mikeneiderhauser/net2rf-led/docs/API.md

# HTTP API

All endpoints are JSON. POST bodies are JSON objects. Errors return `{"ok": false, "error": "..."}` with a 4xx/5xx status.
Successful writes return `{"ok": true, "reboot": <bool>}`; when `reboot` is true the controller restarts about a second later.

## Request rules

Every state-changing `POST` must:

- send a JSON body with `Content-Type: application/json` (otherwise `415`);
- address the controller by IP or by its own name (`net2rf-xxxx`, `net2rf-xxxx.local`, `net2rf.local`);
  any other host name gets `403`, including the same name under another domain (`net2rf-xxxx.lan`), since a
  DNS-rebinding page can pick its own domain. Use the IP when your router publishes its own DNS names;
- if sent from a browser, come from the controller's own page (the `Origin` header must match).

These stop other websites from making your browser change settings or flash firmware behind your back. Scripts,
curl and Home Assistant are unaffected as long as they set the JSON content type. `/update` (multipart) is exempt from
the content-type rule but not from the other two.

## Authentication

Off by default. Once an admin password is set (`POST /api/auth`), every endpoint marked 🔒 needs HTTP Basic auth
with user `admin`:

```bash
curl -u admin:yourpassword http://net2rf-3f2a.local/api/config
```

Missing or wrong credentials return `401` with a `WWW-Authenticate: Basic` challenge (browsers show a login prompt).
After 5 wrong passwords, all attempts are refused with `429` for 30 s. The password is stored as a salted SHA-256
hash. Basic auth is not encrypted on the wire, so treat it as protection on a trusted LAN, not across the internet.
Forgotten password: hold the front-panel button 5 s (network reset), which clears it along with the network settings.

| Method | Path | Purpose |
|---|---|---|
| GET | `/` | Web UI |
| GET | `/api/status` | Device, network and engine status (polled by the UI every second). Always open. `device.free_heap` / `min_free_heap` / `heap_bytes` are RAM in bytes (free now, lowest since boot, total); `device.firmware_bytes` and `device.firmware_slot_bytes` give the firmware's size and the flash slot it must fit in (free flash = the difference). |
| GET | `/json/info`, `/json/cfg` | The part of WLED's JSON API that xLights' WLED upload driver reads: device info, and port 1's pixel count (= zones) and input. `brand` is `Net2RF`, so xLights' WLED discovery ignores the controller. Always open. |
| POST 🔒 | `/json/cfg` | What xLights posts on *Upload*: `hw.led.ins[0].len` sets the number of zones (pixel mode; 1-16), `if.live.port` 4048 enables DDP and 5568 enables E1.31 with `if.live.dmx.uni`. Start channel becomes 1. A zone added this way gets its own group unless it was configured before. WLED's per-port colour order is ignored (it describes LED wiring; the controller's colour order must match the model's String Type). Art-Net, more than one port or more than 16 pixels return 400. |
| GET | `/api/flash` | Flash chip size and the partition table: `label`, `offset`, `bytes`, `kind`, and `used_bytes` for the running firmware slot and the settings store. Shown under *System → Advanced: flash storage*. Always open. |
| GET 🔒 | `/api/crash` | The last crash, from the dump the controller keeps in flash: `present`, `task`, `reason`, `pc`, `address`, `backtrace` (addresses to look up in that build's `firmware.elf`), `elf_sha256`. Stays until the next crash. |
| GET | `/api/heap` | Memory diagnostics: `free`, `largest_block` (what one big allocation can get), `min_free`, block counts, and per task `stack_unused`. |
| GET 🔒 | `/api/store` | Board records kept on the data partition: `mounted`, `total_bytes`, `used_bytes`, `boot_no`, `writes` (file writes over the partition's life), `record_seen`, `boot_log_paused`, and `files` (`name`, `bytes`). See [Board records](#board-records). |
| POST 🔒 | `/api/store` | `{"record_seen": true}`: also write the transmitters receiver mode hears to flash (off by default). |
| GET 🔒 | `/api/store/boots` | The boot log: `boots` (count since the log began), `abnormal_streak`, `entries` (`n`, `reason`, `fw`, `prev_uptime_s`, and `pc` after a crash), oldest first, the last 32. |
| GET 🔒 | `/api/store/seen` | Transmitters receiver mode has decoded: `entries` (`protocol`, `address`, `group` for protocol 1, `count`, `first_boot`, `last_boot`, `best_rssi_dbm`). |
| GET 🔒 | `/api/store/captures` | Saved captures without their pulses; with `?slot=N` one capture in full (same shape as `/api/rx/capture`). |
| POST 🔒 | `/api/store/captures` | `{"id": N, "note": "..."}` keeps receiver capture N (replies `slot`; 507 when all 6 slots are used). `{"delete": slot}` frees one. |
| POST 🔒 | `/api/store/clear` | `{"what": "boots" \| "seen" \| "captures" \| "all"}` |
| GET 🔒 | `/api/store/file?name=boots.json` | One stored file, as a download. |
| POST 🔒 | `/api/store/file` | `{"delete": "cap0.json"}` deletes one stored file. `boots.json` restarts the restart count, `seen.json` empties the heard list, `store.json` puts recording back to off. |
| GET 🔒 | `/api/store/bundle` | One diagnostics file for a fault report: status, last crash, boot log, heard transmitters, saved captures (no pulses) and settings. Never the Wi-Fi or admin password. |
| GET 🔒 | `/api/config` | Current settings (`app` + `network`, without passwords) |
| POST 🔒 | `/api/config` | Update app settings. Any subset of the fields below. Changing `radio.type` reboots. |
| POST 🔒 | `/api/network` | Update network settings, then reboot |
| GET | `/api/stats` | Compact counters for monitoring (see below). Always open. |
| GET | `/api/discover` | This controller plus every other controller it knows of, with live state (see *Controller discovery*). Always open. |
| POST | `/api/discover` | Run an mDNS search now (otherwise every 60 s; heartbeats arrive continuously) |
| POST 🔒 | `/api/auth` | `{"password": "..."}`: set or change the admin password (8-64 characters); `""` removes it |
| POST 🔒 | `/api/output` | `{"enabled": true\|false}`: global RF switch (persisted). Disabled = DDP is consumed and counted, nothing is transmitted. |
| POST 🔒 | `/api/radio` | `{"power": true\|false}`: radio chip power (persisted). `false` puts the chip to sleep: `radio.state` reads `off`, show data is still counted, and sends return 409 (`radio is shut down`). `true` re-initialises it and re-sends the current colours. |
| POST 🔒 | `/api/test` | `{"mode": "off"\|"solid"\|"cycle"\|"fade"\|"flicker", "rgb": "FF0000"}`: override DDP input. **fade** holds each colour of a palette, then fades to the next, round and round: `"palette": ["FF5000", "7000FF", ...]` (1-8 colours), `"fade_s"`, `"hold_s"` (0-600); anything left out keeps the Halloween default (orange, purple, green, red, candle yellow; 3 s / 4 s). It sends a step about every 0.3 s while fading and nothing while holding. **flicker** is a candle in the `rgb` colour: a random level (55-100 %, redder when dimmer) about 3 times a second. `"boot": true` also starts this mode, with its colours, at every power-up; `false` (or `"off"` with `"boot": false`) stops that. The status shows `engine.test` = `{mode, rgb, boot, fade: {palette, fade_s, hold_s}}`. |
| GET | `/api/amp` | Amplifier power switch (see *Amplifier power switch* below): `{fitted, active_low, on, pin, shares_status_led}`. Also in `/api/status` as `device.amp`. Always open. |
| POST 🔒 | `/api/amp` | Any of `{"fitted": true, "active_low": true, "on": false}`, saved and kept across restarts. Returns `{"ok": true, "amp": {...}}`. 400 for a value that isn't true/false. |
| POST 🔒 | `/api/send` | `{"zone": 0, "action": "color"\|"off"\|"fxa"\|"fxb"\|"fxc", "rgb": "FF0000"}` (protocol 0: `fxa` = fade in to the last colour, `fxb` = fade out, `fxc` = a third effect packet with no known result); `"zone": "all"` (or -1) = every bracelet: one broadcast packet on protocol 1, one per enabled zone on protocol 0. `"all"` + `"off"` behaves like `/api/all-off`. 400 for a zone that isn't saved; 409 when output is disabled. |
| POST 🔒 | `/api/all-off` | Leave test mode and switch every bracelet off. Bracelets then stay off until the input changes a colour. 409 when output is disabled. |
| GET | `/api/tools` | Live data for the Tools page: `tx` = the last 24 transmissions, newest first (`age_ms`, `p` protocol, `pkt` hex, `n` repeats, `manual`, `ok`), `tx_total`, and `input` (`start`, `width`, `channels`: the raw values the zones read). Always open. |
| GET 🔒 | `/api/rssi` | Listen on the bracelet frequency for about 20 ms, between transmissions: `peak_dbm`, `avg_dbm`, `freq_hz`. 409 if the radio can't listen (off, not ready). |
| POST 🔒 | `/api/identify` | `{"seconds": 15}` (0-120; 0 stops): flicker the status LED and flash the OLED |
| POST 🔒 | `/api/display` | Any of `{"type": "ssd1306"\|"sh1106", "sleep_min": 10, "wake": true}`: OLED driver, minutes without a USER press before it sleeps (0-240, 0 = never), and switch a sleeping display back on. `device.display_info` in `/api/status` has `asleep`, `sleep_min` and `button`. |
| POST 🔒 | `/api/raw` | `{"protocol": 1, "hex": "55000FFFFF55FF", "repeats": 3, "fix": true}`. 409 when output is disabled. |
| POST 🔒 | `/api/stats/reset` | Zero the packet counters |
| POST / GET 🔒 | `/api/wifi/scan` | Start a scan / read results |
| GET 🔒 | `/api/export` | Download settings. `?part=settings` gives the `app` part, `?part=network` the `network` part, each as its own file; without `part` the file holds both. Passwords are never included. |
| POST 🔒 | `/api/import` | Body = an export file. Replaces the parts it holds (`app`, `network` or both) and leaves the other alone. Reboots. |
| POST 🔒 | `/api/reset` | `{"what": "settings"\|"network"\|"all"}`: put that part back to defaults (`all` = both). Reboots. |
| POST 🔒 | `/api/reboot` | Reboot |
| POST 🔒 | `/api/factory-reset` | Same as `/api/reset` with `all` |
| POST 🔒 | `/api/update/latest` | `{"tag": "v1.2.3"}`: the web UI reports the latest release it found on GitHub, so the dashboard and the OLED can show that a newer version exists. Kept in memory only. The controller never contacts GitHub for updates itself. |
| POST 🔒 | `/update` | `multipart/form-data` firmware upload (`firmware.bin`). Origin and credentials are checked before anything is written to flash. Reboots when done; see *Update rollback*. |

## Amplifier power switch

An optional output that powers an external RF amplifier up and down, e.g. through its 12 V → 5 V buck's EN pin
([assembly guide](ASSEMBLY.md#amplifier-power-switch)). It uses `pin` (IO2 on the WT32-ETH01, D1 on the XIAO).

- `fitted`: a switch is wired to the pin. Until then the firmware leaves the pin alone (default `false`). On the
  WT32-ETH01, IO2 is also the status LED's pin (`shares_status_led`), and the LED is not driven while a switch is
  fitted.
- `active_low`: the pin is low while the amp is on (default `true`): an N-FET that pulls the buck's EN low when the
  pin goes high. `false` for a switch that is on while the pin is high (e.g. a high-side P-FET driven through an
  N-FET).
- `on`: the amp is powered. Kept across restarts. Reads `false` while no switch is fitted.

Before the firmware starts, IO2 is low (it must be, for serial flashing), so with an active-low switch the amp is
powered during boot.

## Settings (`/api/config` → `app`)

```json
{
  "name": "Front Yard",
  "output_enabled": true,
  "role": "controller",
  "devices": {"protocols": [0, 1], "per_zone": true, "protocol": 0, "mode": "pixel", "color_order": "RGB"},
  "input":     {"ddp_enabled": true, "ddp_port": 4048, "e131_enabled": false, "e131_universe": 1,
                "e131_multicast": true, "start_channel": 1, "timeout_s": 300},
  "radio":     {"type": "cc1101", "tx_power": 10, "freq_p0": 433889000, "freq_p1": 433920000,
                "repeats": 3, "off_threshold": 16, "refresh_ms": 0, "tx_jitter_ms": 0,
                "lbt_enabled": false, "lbt_threshold_dbm": -75, "power": true},
  "sync":      {"enabled": false, "master": false, "copies": 1},
  "zones": [
    {"enabled": true, "name": "Bracelets", "protocols": [0], "addr_p0": "0002000F", "addr_p1": "01FF", "start": 1},
    {"enabled": true, "name": "Pucks", "protocols": [1], "addr_p0": "0004000F", "addr_p1": "05FF", "start": 4},
    {"enabled": true, "name": "Everyone", "protocols": [0, 1], "addr_p0": "00FFFF0F", "addr_p1": "00FF", "start": 7}
  ]
}
```

- Protocols: 0 = Shenzen New Dody (433.889 MHz, 10-colour palette), 1 = LedGiftSupplier.com (433.920 MHz, RGB,
  group codes). **Each zone drives its own** (`zones[].protocols`: `[0]`, `[1]` or `[0, 1]`), and only those go
  on air: a zone on `[0]` never costs protocol 1 airtime. A zone on both sends every change twice, protocol 0 then
  protocol 1 (an FX channel effect becomes "off" for fade out, and the plain colour otherwise, on protocol 1,
  which has no effects). Broadcasts (All off, input-timeout blanking, test colours) go only to protocols some
  enabled zone uses.
- `devices.protocols` (write): sets every zone at once. Read: what every zone uses, or, with `per_zone: true`,
  what the zones use between them. `devices.protocol` is the default protocol (new zones when they differ, the
  channel meter); an older client that changes it switches every zone to that protocol. Zones always keep an
  address in both protocols, so nothing has to be re-entered when a zone changes protocol.
- `devices.base_layer` (protocol 0): the zone addressed to every group (mask `FFFF`) is a base layer. A zone
  whose colour is not black is cut out of that zone's address ("everyone except"), so base changes don't
  reach it; a black zone follows the base and gets no packet of its own while the base's broadcast covers
  it. Zones that change to the same command at the same moment are sent as one packet with their masks
  combined. Default `true` for new settings, `false` for settings saved by older firmware. In `/api/status` the
  base zone's `packet` shows the address actually used (e.g. `00FBFF0F` with group 2 cut out).
- `devices.mode`: `pixel` (3 channels per zone: R G B in `color_order`), `dmx` (4: R, G, B, FX) or `vendor`
  (5: boot code, group, R, G, B, the LedGiftSupplier DMX transmitter's layout). Vendor mode drives protocol 1 only,
  so every enabled zone must use protocol 1 (a zone also on protocol 0 sends only protocol 1). A zone only transmits
  while its first channel is 85, and the group comes from its second channel.
- `zones[].addr_p0`: 4 bytes (packet bytes 0-3; `00FFFF0F` = all groups, `0002000F` = group 1, `0004000F` =
  group 2, ...). `zones[].addr_p1`: group code byte + byte 6 (`00FF` = group 0, all groups; `01FF` = group 1).
  Factory default: protocol 0 with five zones, *All Zones* and *Zone 1* to *4* (groups 1-4). Zone *k* defaults
  to group *k* in both protocols, and zone 0 to all groups. `zones[].start` is read-only: zone *k* starts at
  `start_channel + k × (3, 4 or 5)`. Older clients and exports may send one `addr` per zone: it is read in the
  default protocol, and the zone then drives that protocol alone. Settings saved by firmware before per-zone
  protocols load with every zone on the controller's old protocol and its address kept.
- `/api/status` → `engine.zones[].packets`: the last packet sent on each of the zone's protocols (`p`, `pkt`);
  `packet` is the first of them.
- Transmit order: zones are sent when their colour changes, taking turns. When zones that reach the same
  bracelets change together, the broader address goes first (all groups before a single group), so the more
  specific colour lands last.
- `radio.type`: `cc1101` or `sx1278`. A new or reset controller starts on `sx1278` (WT32-ETH01) or `cc1101` (XIAO ESP32-S3). `tx_power` is clamped to the module's range. `refresh_ms` defaults to 0
  (send on change only): the bracelets latch, and extra airtime only adds interference.
- `radio.power`: `false` = radio chip shut down (same as `POST /api/radio`).
- `role`: `controller` (default) or `receiver`. A receiver never transmits: it listens between the two protocol
  frequencies and decodes both protocols. `/api/status` → `engine.receiver` has `enabled`, `active` (listening),
  `supported` (CC1101 fitted), `freq`, `frames` (decoded), `bad` (right shape, wrong checksum), `updates`
  (distinct commands), `rssi_dbm` / `rssi_peak_dbm` (channel level over the last 0.5 s), `last_age_ms`, `zones`
  (per group: `p`, `group` (`"all"` = every group), `rgb`, `label` (protocol 0 colour or effect), `pkt`, `updates`,
  `age_ms`, `rssi_dbm`) and `noise_pauses` (times a flood of noise edges paused listening for 50 ms, to keep the controller responsive), `log`
  (latest transmissions, newest first: `p`, `pkt`, `n` copies heard, `rssi_dbm`,
  and for protocol 1 `checksum`: `vendor` or `legacy`). `POST /api/stats/reset` clears it. Transmit requests return
  409 in receiver mode.
- `rx_profile`: receiver tuning, `normal` (default), `near` (gain capped, for a transmitter within a few metres) or
  `wide` (wider bandwidth). `engine.receiver.profile` and `.bandwidth` (Hz) report it.
- Raw captures: `engine.receiver.captures` lists the stored bursts, newest first (`id`, `age_ms`, `pulses`, `us`
  total length, `decoded`, `truncated` at 1024 pulses, `rssi_dbm` peak). `captures_quiet` counts bursts dropped
  for being no louder than the noise floor. `GET /api/rx/capture?id=N` returns one: `pulses` is a list of
  durations in µs, positive = carrier on, negative = off. Add `&format=ook` for rtl_433's pulse-data text.
- `display.sleep_min`: minutes without a USER button press before the OLED switches off (default 10, 0 = never).
- `update.repo`: GitHub repository (`owner/name`) whose releases the web UI offers as firmware updates.
  Default `mikeneiderhauser/net2rf-led`; `""` restores the default.
- `radio.lbt_enabled` (listen before transmit, off by default): before each update the radio listens for 2.5 ms
  and only transmits if the strongest signal stayed below `lbt_threshold_dbm` (-120..-30, default -75).
  Otherwise it backs off a random 3-15 ms and listens again, for at most 250 ms, then sends anyway. Set the
  threshold about 10 dB above the quiet reading shown on *Devices & Radio* (`radio.lbt.last_rssi_dbm` in
  `/api/status`). See [RF.md](RF.md#multiple-controllers).
- `sync`: coverage group ([RF.md](RF.md#coverage-group)). `enabled` takes part; `master` (with `enabled`) makes this
  controller the one that receives the show and schedules every controller's slot; `copies` (1-3) is the frames each
  controller sends per change, used by the master for the whole group. Ignored in receiver mode. `/api/status` →
  `group`: `role` (`off`, `master`, `remote`), `mac`, `masters` (other masters alive: `name`, `mac`, `ip`), `conflict`
  (more than one master). Master: `remotes` (`name`, `mac`, `ip`, `state` = `joining` / `synced` / `sync_poor` / `lost`,
  `error_us`, `sync_age_ms`, `on_time`, `late`, `missed` as the remote reports them), `plans`, `last_plan` (`order`,
  `copies`, `guard_us`, `lead_us`, `length_us`, `age_ms`). Remote: `following`, `master` (`name`, `mac`, `ip`,
  `ack_age_ms`), `clock` (`synced`, `samples`, `offset_us`, `error_us`, `rtt_us`), `on_time`, `late`, `missed`,
  `last_tx_age_ms`. `engine.output` adds `group_plans`, `group_settles` (master) and `group_slots`, `group_skipped`
  (remote).
- `input.timeout_s`: blank the bracelets after this long without input. 0 = hold the last colour. On protocol 1 the
  blank is one broadcast "off" to every group (so it also reaches bracelets in groups no zone uses).
- Test mode (`/api/test`) on protocol 1 also uses one broadcast per colour change rather than one packet per zone.
- `input.e131_*`: E1.31 listens on UDP 5568 for one universe (slots 1-512 = channels 1-512); with multicast it also
  joins 239.255.*hi*.*lo* for that universe. Off by default so a shared universe can't drive the bracelets by accident.

## Stats (`/api/stats`)

```json
{
  "uptime_s": 86400, "free_heap": 182344, "name": "Front Yard", "output_enabled": true,
  "radio": "ready", "test_mode": "off",
  "input":  {"packets": 1204233, "frames": 1204233, "malformed": 0, "ignored": 2, "bytes": 19267728, "fps": 40.0,
             "seen": true, "timed_out": false, "age_ms": 25, "source": "192.168.1.20", "timeout_s": 300},
  "output": {"enabled": true, "suppressed": 0, "updates": 81234, "frames": 243702, "errors": 0, "manual": 4,
             "airtime_pct": 38.5, "lbt_checks": 81234, "lbt_waits": 120, "lbt_forced": 2, "lbt_wait_ms": 940},
  "zones":  [{"name": "Left side", "enabled": true, "rgb": "FF0000", "updates": 40617, "last_tx_age_ms": 120}]
}
```

`test_mode` is `off`, `solid`, `cycle`, `fade` or `flicker`.

`input.packets`/`frames` count every valid DDP or E1.31 packet and frame (`ddp_packets` / `e131_packets` split
them; `last_source` is the protocol of the last one, `source` its sender's IP); `output.suppressed` counts zone updates that
were consumed while output was disabled. With listen before transmit on, `lbt_checks` counts updates that
listened first, `lbt_waits` those that found the channel busy, `lbt_forced` those sent anyway after 250 ms, and
`lbt_wait_ms` the total delay. A steadily rising `lbt_forced` means the channel is saturated: lower the load
(fewer updates, fewer repeats) or the number of transmitters. `POST /api/stats/reset` zeroes the counters.

`firmware` is the running version, and `update` the latest release a browser has reported (`POST /api/update/latest`),
also in `/api/status` as `device.update_check`:

```json
"firmware": "0.0.3",
"update": {"available": true, "latest": "v0.0.4", "reported_ago_s": 840}
```

`available` is true when `latest` is newer than the running firmware. `latest` and `reported_ago_s` are missing
until a browser has reported one since the controller started.

## Controller discovery

Controllers find each other two ways:

- **Heartbeat (live state):** every 5 s each controller broadcasts a small JSON packet on **UDP 4049** on every
  active interface (Ethernet, Wi-Fi, setup AP):
  ```json
  {"p":"net2rf","v":1,"id":"24DB","name":"Front Yard","host":"net2rf-24db","fw":"1.2.0",
   "radio":"ready","input":"live","out":true,"test":false,"zones":4,"air":12,"up":86400}
  ```
  `input` is `live` (data in the last 3 s), `idle`, `timed_out` or `none`; `air` is the controller's RF
  airtime over the last 10 s (%). A controller that has just started
  adds `"hello":true`; the others answer at once (broadcast, plus directly to the sender, which also works
  across subnets). A beat also goes out immediately when the radio, input, output or test state changes. The
  sender's IP is taken from the packet, not the payload. Firmware with coverage groups adds `"mac"` (12 hex digits,
  the Ethernet MAC: a stable identity), `"sync"` (takes part in a coverage group) and, with `sync`, `"master"`.
  The master lists every controller whose beat has `sync` and not `master`; a remote follows the one with both.
- **Coverage group (UDP 4050, unicast only):** remote → master `SYNC` every second, master → remote `SYNC_ACK`
  (NTP-style timestamps), and master → remote `TX` per change (slot start on the master's clock, copies,
  protocol, frequency, packet). Binary, little-endian, starting `N2RG`, version 1; see
  `lib/net2rf_group/group_sync.h`.
- **mDNS** (`_net2rf._tcp`, every 60 s): finds controllers whose heartbeats can't reach this one, such as older
  firmware or Wi-Fi with client isolation. They're listed without live state.

Broadcasts and mDNS stay on the local subnet; controllers on different VLANs don't see each other.

**Falcon Player and xLights** find the controller a third way: it answers FPP's *discover* ping on **UDP 32320**
(multicast 239.70.80.80, broadcast or unicast) with a version 3 ping packet: system type `0xC0` (other system), mode *bridge*, its IP, hostname, firmware
version, model `Net2RF-LED` and its channel range (for example `0-47`). It sends one such ping when the
network comes up and otherwise only when asked, at most once a second, and replies both to the multicast
group and directly to the asker. It takes no part in MultiSync playback.

FPP has not assigned this controller a type code, and it does not borrow another product's. Players
therefore list it by hostname and model without knowing what it is, and xLights creates it as an E1.31
controller with no vendor: set DDP, *Keep Channel Numbers* off and the vendor yourself. The model string is
the ID of the xLights controller definition in [`tools/xlights`](../tools/xlights/).

`GET /api/discover`:

```json
{"running": false, "alias": "net2rf.local", "alias_claimed": true,
 "controllers": [
   {"name": "Front Yard", "hostname": "net2rf-24db", "ip": "192.168.1.60", "firmware": "1.2.0", "id": "24DB",
    "self": true, "online": true, "last_seen_ms": 0, "via": ["self"],
    "state": {"radio": "ready", "input": "live", "output_enabled": true, "test": false, "zones": 4,
              "airtime_pct": 12, "uptime_s": 86400}},
   {"name": "Back Yard", "hostname": "net2rf-81c4", "ip": "192.168.1.61", "firmware": "1.2.0", "id": "81C4",
    "self": false, "online": false, "last_seen_ms": 42000, "via": ["udp", "mdns"], "state": {"...": "last known"}}]}
```

- `online`: a heartbeat arrived in the last 15 s (three missed beats = offline). Offline controllers stay
  listed for 10 minutes, then drop off.
- `via`: `udp` (heartbeat), `mdns`, or `self`. Entries seen only via mDNS have no `state`.
- `alias_claimed`: this controller currently answers `net2rf.local`. Exactly one controller does: the one with
  the lowest ID among those it can see, re-elected as controllers come and go.

`tools/peer_sim.py` simulates other controllers for testing.

## Update rollback

A newly uploaded firmware boots as *pending*. It is confirmed once the controller has been reachable (web UI up,
with a network connection or the setup AP) for 30 s. If it crashes or reboots before that, the bootloader
returns to the previous firmware on the next boot; if it never becomes reachable within 3 minutes, it rolls
itself back. `/api/status` reports `device.update_pending` and `device.update_rolled_back`. This applies to
uploads and to installs from GitHub alike.

## Network (`/api/network`)

```json
{"hostname": "net2rf-3f2a", "eth_enabled": true, "wifi_ssid": "HomeNet", "wifi_pass": "…",
 "dhcp": false, "ip": "192.168.1.60", "subnet": "255.255.255.0", "gateway": "192.168.1.1", "dns": "",
 "ap_mode": "no_connection", "ap_pass": "net2rf1234"}
```

Omit `wifi_pass` / `ap_pass` to keep the current ones. `ap_mode`: `no_connection` (default), `always`, `never`.

## Board records

The controller keeps three kinds of record as small JSON files on its 128 KB data partition (LittleFS on the
partition labelled `spiffs`), so they survive restarts, firmware updates and a factory reset. A full flash erase
removes them. Nothing depends on them: a board without the partition simply reports `mounted: false`.

| File | Holds | Written |
|---|---|---|
| `boots.json` | The last 32 restarts: why, on which firmware, how long the run before lasted, and the crash address when there was a core dump | Once per boot. After 5 abnormal restarts in a row nothing is written until a boot has stayed up for a minute; that entry then says how many were `skipped` |
| `seen.json` | Up to 64 transmitters heard in receiver mode, by protocol and address | Only with *Record this list to flash* switched on: a new transmitter within a minute, updated counts every 15 minutes, never during a firmware update |
| `store.json` | The recording setting | When it is changed |
| `cap0.json` ... `cap5.json` | Raw captures kept with **Keep** on the Receiver page | When kept |

`/api/flash` also reports the flash chip itself: `flash_chip_bytes` (the real size, from the chip), `flash_id`
(JEDEC id), `flash_maker_id`, `flash_mode` and `flash_speed_hz`. `flash_bytes` stays the size the firmware was
built for; on a board with a larger chip the difference is unused.

**Flash wear.** The partition is 32 blocks rated for about 100,000 erases each, and writing a small file costs
about two, so it is good for roughly a million writes. One write per boot is centuries of normal use; the two
cases that could matter are paced: a restart loop stops writing the boot log, and the heard list is opt-in
and written at most every 15 minutes (a new transmitter within one). Every file carries the running total as
`w`, reported as `writes`.

## Firmware updates

Firmware is installed by uploading a `.bin` to `POST /update`: a file picked in the web UI, or one the web UI
fetched in the browser from the project's GitHub Pages site (the latest release only). The controller does not
download firmware and does not check for releases: a secure connection needs about 100 KB of heap, which left
about 7 KB free while it ran. `device.update_check` is `{available, latest?, reported_ago_s?}`. Nothing in the
firmware opens a secure connection, and the TLS stack is not linked in.
