mikeneiderhauser/net2rf-led/docs/images/output.png

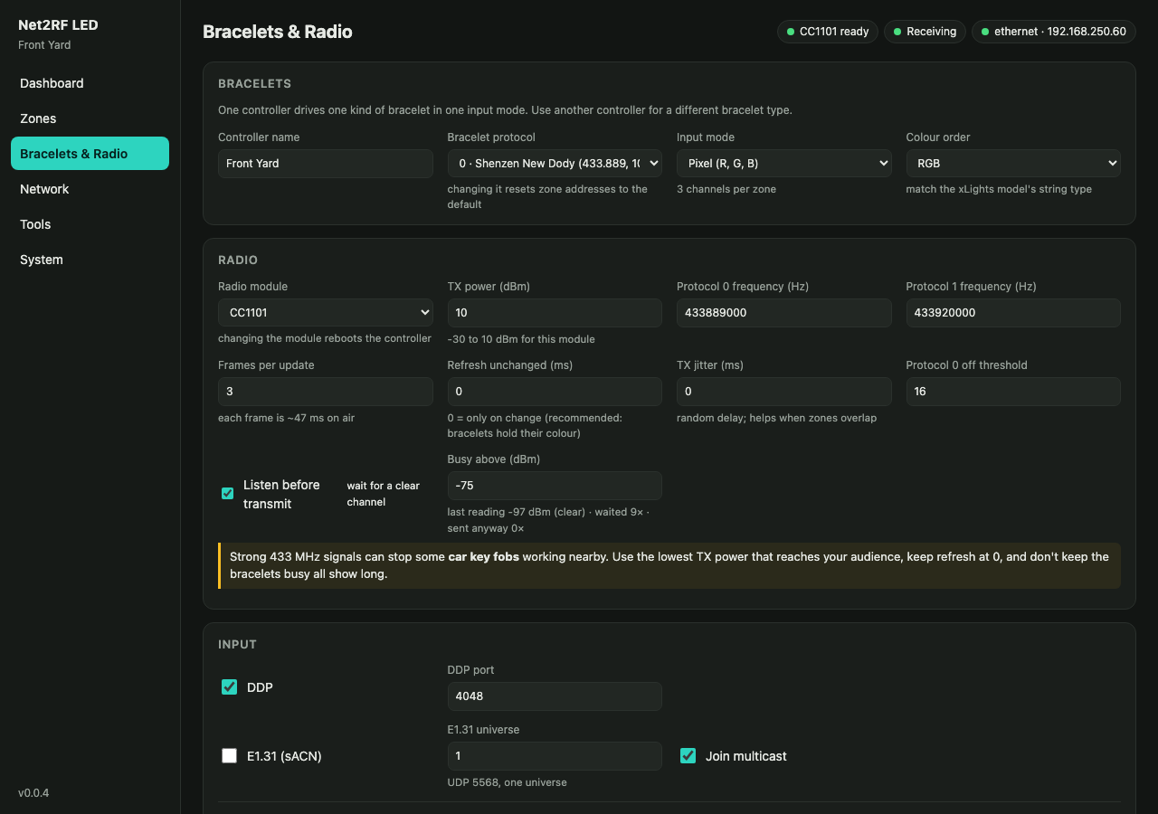
docs/images/output.png
