mikeneiderhauser/net2rf-led/docs/images/tools.png

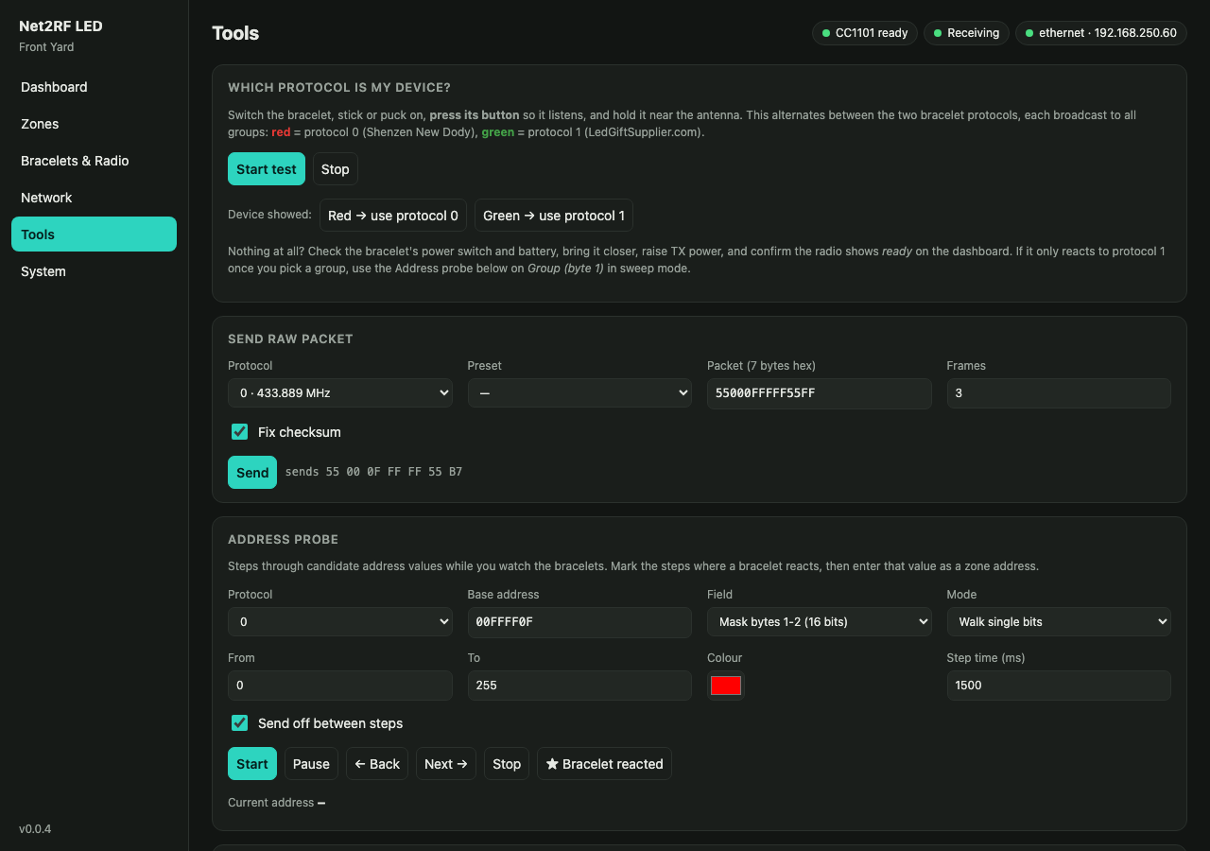
docs/images/tools.png
