mikeneiderhauser/net2rf-led/hardware/case/images/antenna-plug.png

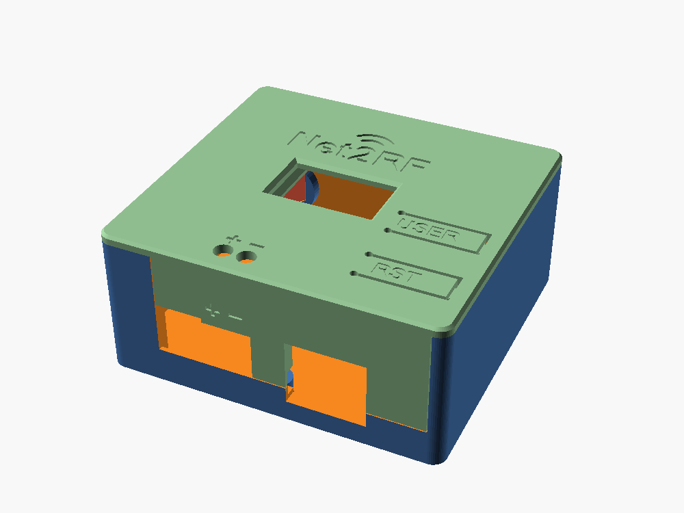
hardware/case/images/antenna-plug.png
