mikeneiderhauser/net2rf-led/hardware/case/amp/base.stl

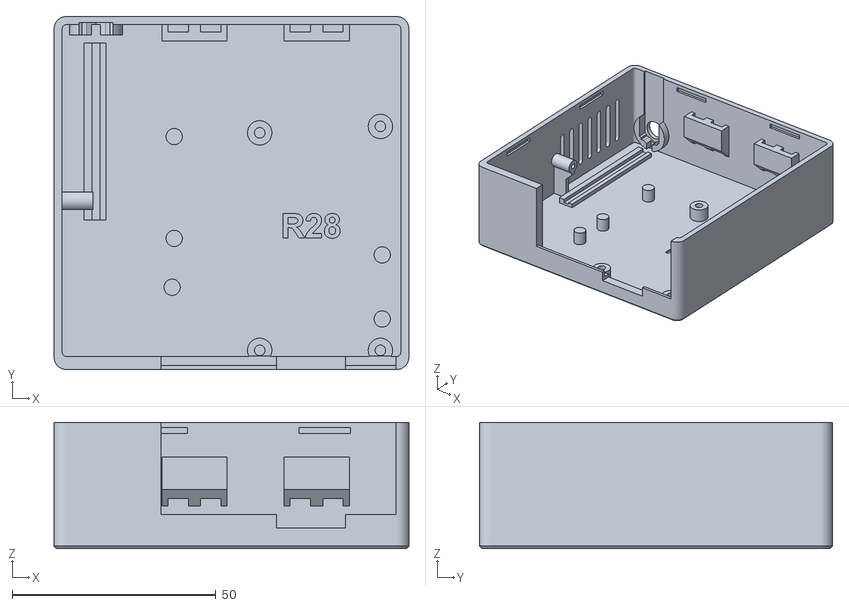
[picture p11: CAD file, 2026-10-31]
hardware/case/amp/base.stl
87.2 x 86.7 x 31.0
