mikeneiderhauser/net2rf-led/hardware/case/slim/lid-slim-ssd1315.stl

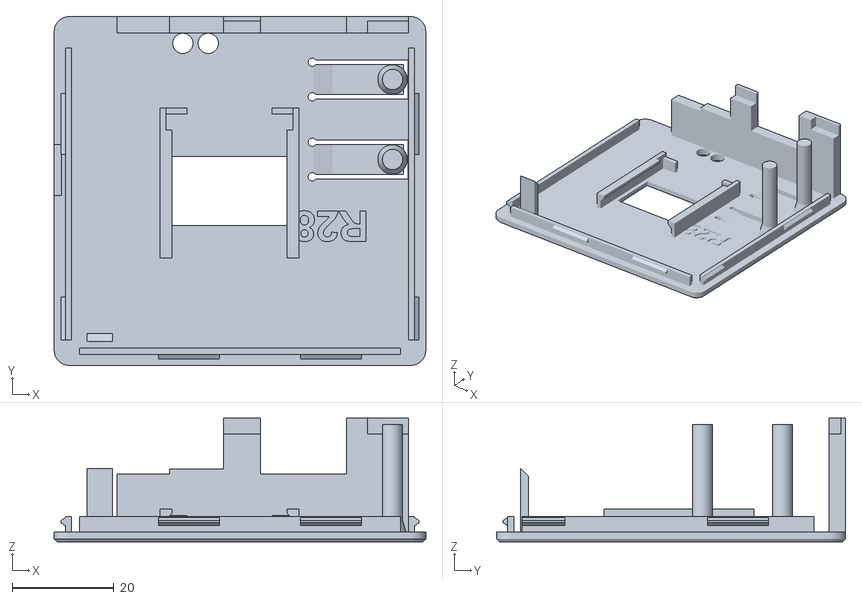
[picture p12: CAD file, 2026-10-31]
hardware/case/slim/lid-slim-ssd1315.stl
73.2 x 68.7 x 24.4
