mikeneiderhauser/net2rf-led/hardware/case/amp/bracket.stl

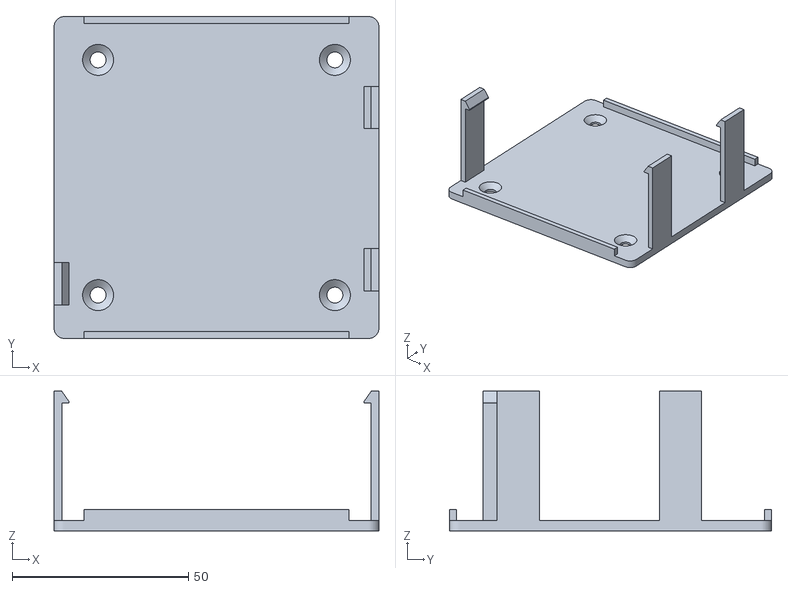
[picture p13: CAD file, 2026-10-31]
hardware/case/amp/bracket.stl
92.2 x 91.3 x 39.6
