mikeneiderhauser/net2rf-led/hardware/case/slim/antenna-plug.stl

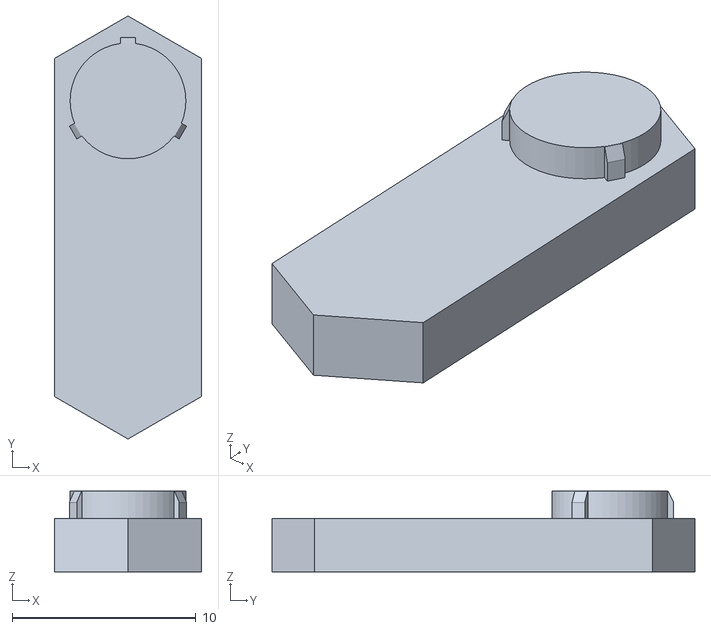
[picture p14: CAD file, 2026-10-31]
hardware/case/slim/antenna-plug.stl
8.00 x 23.0 x 4.40
