mikeneiderhauser/net2rf-led/docs/ASSEMBLY.md

# Assembly and installation

Two ways to build a controller:

- **[A. DIY build](#a-diy-build)**: a WT32-ETH01 and a radio module wired together. Available now; this is
  what the firmware has been tested on.
- **[B. Carrier board](#b-carrier-board-coming-soon)**: coming soon.
- **[C. XIAO ESP32-S3](#c-xiao-esp32-s3)**: a small Wi-Fi-only alternative, wired like
  [CrispyPyro/Wireless_DMX_Receiver](https://github.com/CrispyPyro/Wireless_DMX_Receiver). Builds; not yet tested
  on hardware.

A and B run the same firmware with the same pin assignment; C has its own build (`xiao-esp32s3`). Once flashed, the [user guide](USAGE.md) covers
connecting and everyday use, and [SETUP.md](SETUP.md) covers adding the bracelets to your show.

---

## A. DIY build

### Parts

| Part | Notes |
|---|---|
| **WT32-ETH01** ([Amazon](https://www.amazon.com/dp/B09Z298QJQ)) | ESP32 + LAN8720 Ethernet. Power it with 5 V; its own 3.3 V regulator also supplies the radio and OLED. (Not the "WT32-ETH01-EVO", which is a different chip and pinout.) |
| **Radio, one of:** | Chosen in the web UI (*Devices & Radio → Radio module*), no recompiling. Fit only one. |
| CC1101 module, **433 MHz** | The blue 2×4-header board with an SMA jack, e.g. [AOICRIE CC1101 + antenna](https://www.amazon.com/dp/B0D2TMTV5Z). −30 to +10 dBm. **Tested.** Multi-band listings ("315/433/868/915") are only tuned for one band: make sure yours is 433 MHz. |
| Ai-Thinker Ra-02 (SX1278, 433 MHz) | [Ra-02 module](https://www.amazon.com/SX1278-Ai-Thinker-Wireless-Spectrum-Transmission/dp/B0CP778J3T): +2 to +17 dBm, the long-range option. **Supported, not yet tested on hardware.** It has a u.FL antenna connector and 2 mm pads, so use a breakout: [ACROBOTIC Ra-02 breakout](https://www.amazon.com/ACROBOTIC-Breakout-Arduino-ESP8266-Raspberry/dp/B07MNH5W65), or [Adafruit RFM96W 433 MHz](https://www.adafruit.com/product/3073) (equivalent chip, 0.1" header). |
| 433 MHz antenna | Included with the linked CC1101. For the Ra-02: a u.FL→SMA pigtail + 433 MHz SMA whip. Mount it high. |
| 128×64 I²C OLED (optional) | SSD1306 (0.96", e.g. [this one](https://www.amazon.com/dp/B09T6SJBV5)) or SH1106 (1.3"), selectable under *System → Display*. Shows IP, radio status, input rate, zone colours. Everything works without it. |
| 3 × tactile buttons ([Amazon](https://www.amazon.com/dp/B01E38OS7K)) | EN (reset), BOOT (IO0), and an optional USER button on IO39. |
| 10 kΩ resistor ([Amazon](https://www.amazon.com/dp/B0BR68QQPF)) | Pull-up for the USER button (IO39 has no internal pull-up). |
| 330 Ω–1 kΩ resistor | In series with the radio data line (IO33). Cheap insurance against two outputs fighting. |
| 3.3 V USB-serial adapter | FT232 / CH340 / CP2102 "FTDI" board, e.g. [this FT232RL USB-C one](https://www.amazon.com/dp/B0DDGLRY1D), for the first flash only. Set it to **3.3 V**. |
| 5 V / 1 A supply | The controller draws ~400 mA worst case. |
| Breadboard ([Amazon](https://www.amazon.com/dp/B07LFD4LT6)) and Dupont jumper wires ([Amazon](https://www.amazon.com/dp/B01EV70C78)) | For a solderless build like the prototype. |

**Avoid** UART "LoRa" modules (EBYTE E32/E22, DL-LL02): they can't send raw OOK.

Links are examples of matching parts, not endorsements. Listings change, so check the band (433 MHz) before buying.

### Pinout

Wiring diagram: WT32-ETH01 to CC1101, optional OLED and buttons

The WT32-ETH01 silkscreen labels some pins by their original serial-bridge function; both names are given below.

#### Radio (fit one; both use the same pins)

A new or reset WT32-ETH01 controller expects the Ra-02 (SX1278); pick CC1101 under Settings > Radio if that is
what you fitted. The XIAO ESP32-S3 build starts on CC1101.

| WT32-ETH01 pin | Silkscreen | Function | CC1101 | Ra-02 (SX1278) |
|---|---|---|---|---|
| 3V3 | 3V3 | Power | VCC | 3.3V |
| GND | GND | Ground | GND | GND |
| IO4 | IO4 | SPI SCK | SCK | SCK |
| IO14 | IO14 | SPI MOSI | MOSI (SI) | MOSI |
| IO35 | IO35 | SPI MISO | MISO (SO) | MISO |
| IO15 | IO15 | Radio CS | CSN | NSS |
| IO33 | 485_EN | OOK data (via 330 Ω–1 kΩ) | GDO0 | DIO2 |
| IO32 | CFG | Radio reset | not used | RESET |

The firmware checks the CC1101's GDO0 → IO33 connection at boot. A broken data wire shows as **data line fault**
on the dashboard, instead of the radio silently keying up with nothing on it.

#### Everything else

| WT32-ETH01 pin | Silkscreen | Function | Connection |
|---|---|---|---|
| 5V | 5V | Power in | 5 V supply |
| IO5 | RXD | I²C SCL | OLED SCL (optional) |
| IO17 | TXD | I²C SDA | OLED SDA (optional) |
| IO39 | IO39 | USER button (optional) | button to GND, 10 kΩ pull-up to 3V3 |
| IO1 | TXD0 | Serial TX | adapter **RX** (first flash) |
| IO3 | RXD0 | Serial RX | adapter **TX** (first flash) |
| EN | EN | Reset | button to GND |
| IO0 | IO0 | BOOT | button to GND |

- Leave **IO12** unconnected: it must be low at boot.
- **IO2** drives the WT32-ETH01's onboard LED (the status LED). Don't wire anything else to it: pull-ups on
  IO2 break serial flashing.
- **IO0** is also the Ethernet 50 MHz clock once running. Only press BOOT while resetting, and keep wiring
  on it short.
- The OLED pins are labelled `RXD`/`TXD`, not `TXD0`/`RXD0`, which is easy to mix up. If SDA and SCL are
  swapped, the firmware detects it and carries on.

### Flashing

#### First time (serial)

1. Wire the USB-serial adapter, set to **3.3 V logic**:

   | Adapter | WT32-ETH01 |
   |---|---|
   | GND | GND |
   | TX | RXD0 (IO3) |
   | RX | TXD0 (IO1) |

   Power the WT32-ETH01 from its own 5 V supply: an adapter's 3.3 V pin can't supply enough current.
2. Enter the bootloader: **hold BOOT, tap EN, release BOOT**.
3. Flash, either way:
   - **Browser:** open the [web flasher](https://mikeneiderhauser.github.io/net2rf-led/) in Chrome or Edge and click **Install**. It always
     flashes the latest release.
   - **Command line:**
     ```bash
     python3 -m esptool --chip esp32 write-flash 0x0 net2rf-led-<version>.factory.bin
     ```
     Download it from the [latest release](https://github.com/mikeneiderhauser/net2rf-led/releases/latest). The `.factory.bin` contains the bootloader, partition
     table and app, so it goes at address `0x0`. Building from source: `pio run -e wt32-eth01` writes
     `firmware.factory.bin` to `.pio/build/wt32-eth01/`.
4. Tap **EN** to run the new firmware.

#### Afterwards

Screw the antenna on **before** powering up, then see the [user guide](USAGE.md) for connecting to the controller,
the buttons, LED and OLED, and firmware updates over the network (no cable needed after the first flash).

### Power budget

| Load | Current |
|---|---|
| ESP32 + Ethernet | ~250 mA peak |
| Ra-02 transmitting at +17 dBm | ~90 mA |
| CC1101 transmitting | ~30 mA |
| OLED | ~20 mA |

About 400 mA worst case, within the WT32-ETH01's regulator. Use a 5 V / 1 A supply.

---

## B. Carrier board (coming soon)

> 🚧 **Under construction.** A carrier board the modules plug into is in the works. Details will follow once it
> has been built and tested. Until then, use the [DIY build](#a-diy-build); the carrier board will use the same
> firmware and pin assignment.

---

## C. XIAO ESP32-S3

A Seeed Studio **XIAO ESP32-S3** and a CC1101 module, wired the way
[CrispyPyro/Wireless_DMX_Receiver](https://github.com/CrispyPyro/Wireless_DMX_Receiver) wires them. So a board
built for that project runs this firmware unchanged. It has the same features as the WT32-ETH01 build, receiver
mode included, except that it has **no Ethernet**: it joins Wi-Fi, or opens the setup hotspot. 🧪 Builds, not yet
tested on hardware.

| CC1101 | XIAO pad | GPIO | Notes |
|---|---|---|---|
| VCC | 3V3 | | 3.3 V only |
| GND | GND | | |
| CSN | D3 | 4 | |
| GDO0 | D4 | 5 | OOK data both ways: TX in, and RX out in receiver mode |
| GDO2 | D5 | 6 | not used (fine to leave connected) |
| SCK | D8 | 7 | |
| MISO (SO) | D9 | 8 | |
| MOSI (SI) | D10 | 9 | |

Optional parts:

| Part | XIAO pad | GPIO |
|---|---|---|
| SSD1306 OLED SDA / SCL | D6 / D7 | 43 / 44 |
| SX1278 (Ra-02) reset, instead of a CC1101 | D0 | 1 |
| USER button | the board's **B** (BOOT) button | 0 |
| Status LED | the board's orange LED | 21 |

The BOOT button works as USER once the firmware runs (short press = next OLED page, hold 5 s / 15 s = network /
factory reset). Holding it while the board resets still enters the USB bootloader.

**Flashing:** plug in USB-C and use the [browser flasher](https://mikeneiderhauser.github.io/net2rf-led/), which
picks the S3 firmware by itself. Or build and upload with `pio run -e xiao-esp32s3 -t upload`. If the port doesn't
appear, hold **B**, tap **R**, release B. Later updates work over Wi-Fi from the web UI as on the WT32-ETH01. Release
files for this board are named `net2rf-led-xiao-esp32s3-<version>.bin`, and the controller won't install the other
board's file.
