mikeneiderhauser/net2rf-led/src/ota_guard.h

#pragma once

#include <Arduino.h>

// Firmware-update rollback. After an OTA update the new image boots in "pending verify" state.
// It is only marked good once the controller is actually reachable (web UI up, network or setup AP
// active) and has stayed up for a while. If it crashes or reboots first, the bootloader returns to
// the previous firmware on the next boot; if it hangs without ever getting healthy, we roll back.
namespace ota_guard {

void loop(bool reachable);  // call regularly; `reachable` = web server running and an IP to reach it
bool pending();             // running an update that has not been confirmed yet
bool rolled_back();         // the last update failed and was rolled back

}  // namespace ota_guard
