mikeneiderhauser/net2rf-led/(commit log)

2026-10-02 Initial check-in of net2rf-led
    Firmware for a WT32-ETH01 (ESP32 + Ethernet) that drives 433 MHz wireless
    LED show products (bracelets, light sticks, pucks) from xLights, Falcon
    Player or any DDP / E1.31 source.
    - Bracelet protocols: Shenzen New Dody (protocol 0, 10-colour palette) and
    LedGiftSupplier.com (protocol 1, RGB + group codes).
    - Inputs: DDP and E1.31 (unicast / multicast); pixel, DMX and vendor-DMX
    input modes; up to 16 zones.
    - Radios: CC1101 or SX1278 (Ra-02), selected at runtime; OOK via the ESP32
    RMT; data-line self-test; optional listen before transmit.
    - Networking: Ethernet preferred, Wi-Fi, setup hotspot with captive portal,
    mDNS (net2rf.local election), UDP heartb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
2026-10-02 LBT default -75 dBm, hardware test results, docs cleanup, parts links
    - Listen before transmit: default threshold -85 -> -75 dBm. A quiet CC1101 reads
    -84 to -87 dBm, so -85 waited on noise for every update.
    - Hardware tests on the WT32-ETH01 + CC1101 controller: heartbeat and controller
    list (against tools/peer_sim.py), net2rf.local election, DDP, E1.31 unicast,
    DMX mode colours all pass. Protocol 0 built-in effects got no reaction from
    the tested bracelet; marked unconfirmed and added to TODO.
    - Docs: status table updated, browser flasher and release file names
    (net2rf-led-<version>.bin / .factory.bin), API and Home Assistant fixes.
    - Parts list: purchase links (Amazon affiliate,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
    [config.h]
2026-10-02 Docs: status LED is the WT32-ETH01's onboard LED; drop README release notes
    - Wiring diagram and pinout no longer show an external LED on IO2: the
    WT32-ETH01 has one on board. Note it in the pinout and user guide.
    - README: remove the paragraph on how tagged releases are built.
2026-10-04 Zone defaults, radio shutdown, broadest-first transmit order, probe groups
    - Defaults: protocol 0 with four zones, All Zones (00FFFF0F) and Zone 1-3
    (groups 1-3). Zone N defaults to group N on both protocols; "Add zone" in
    the web UI continues the pattern.
    - Radio shutdown: POST /api/radio {"power": bool} (also radio.power in the
    config) puts the CC1101 / SX1278 to sleep. Persisted; radio state reads
    "off"; sends are refused with 409 "radio is shut down". Dashboard button,
    OLED and heartbeat show it. Tested on the CC1101.
    - Transmit order: a changed zone waits while a broader zone that reaches the
    same bracelets is also waiting, so "All Zones off + Zone 1 red" on the same
    frame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
2026-10-04 Firmware update from GitHub releases
    - System page: "Check for updates" (manual) asks GitHub for the latest release
    from the browser and compares it with the running version; "Install" has the
    controller download the release's .bin over HTTPS (certificate verified
    against the built-in CA bundle) and flash it. The rollback guard applies.
    - POST /api/update/github {"tag", "asset"}; progress in /api/status
    (device.update_job). Tag and file name are restricted to a safe character
    set and the factory image is refused.
    - The release source is a setting (update.repo, GitHub owner/name, default
    mikeneiderhauser/net2rf-led), appended to the saved settings; older records
    are still accept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
2026-10-05 Base layer and zone merging, xLights models and upload, update check, FPP discovery
    Bracelets (protocol 0)
    - Group mask confirmed on two bracelets (groups 2 and 3): masks combine, an
    empty mask reaches nobody, and "everyone except" works.
    - Base layer (bracelets.base_layer): the all-groups zone is a layer under the
    others. A zone showing its own colour is cut out of the All Zones address; a
    black zone follows it. On for new settings, off for saved ones.
    - One packet per colour: zones changing to the same command share a
    transmission through the mask.
    - Effects identified: 05 AA fades in to the last colour, 06 AA fades out. The
    third packet from the Flipper app does nothing. UI labe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
    [config.cpp, config.h, engine.cpp, engine.h, main.cpp, panel.cpp]
2026-10-05 Fix the Linux build of the unit tests: include <cstring> for memcpy
    bracelet_protocol.h and its test used memcpy without the header; Apple's
    libc++ pulls it in indirectly, GCC on the CI runner does not.
    [test_main.cpp]
2026-10-05 Fix "could not reach GitHub" on install; rename the protocol test
    - Installing a release while the controller's own release check was still
    running opened two secure connections at once and failed with
    ESP_ERR_HTTP_CONNECT. The web UI triggers exactly that: "Check for updates"
    starts the check, "Install" follows. The install now waits for a running
    check, and retries a connection that could not be made (3 attempts).
    - Tools: "Which bracelet do I have?" is now "Which protocol is my device?"
    (it applies to sticks and pucks too).
    [updater.cpp]
2026-10-05 Dashboard: RF output and radio power are toggle switches
    Replaces the Disable output / Shut down radio buttons. Switching either off
    still asks for confirmation; cancelling leaves the switch on.
2026-10-05 Tools page: seven new tools; OLED sleep and update marker
    Tools (web UI, with the firmware behind them)
    - Group tester: send a colour, off or a fade to any combination of groups.
    - Range walk: the colour cycle with a counter and the TX power setting.
    - Input monitor: the channel values each zone is reading (GET /api/tools).
    - Transmit log: the last 24 RF packets, decoded (GET /api/tools).
    - Channel meter: live RSSI on the bracelet frequency between transmissions
    (GET /api/rssi).
    - Connection check: DNS, TCP and HTTPS to GitHub (POST / GET /api/net/check).
    - Identify: flicker the LED and flash the OLED (POST /api/identify).
    - The xLights setup card moves to the bottom of the page.
    OLED
    - S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
2026-10-07 Protocol 1: vendor encoding (full 8-bit colour, group in checksum); receiver mode
    Protocol 1 now sends exactly what the LedGiftSupplier DMX transmitter sends, per
    RTL-SDR captures in CrispyPyro/Wireless_DMX_Receiver (docs/gflai-protocol.md, MIT):
    - colour bytes are the inverted 8-bit DMX value (~v) instead of 16 levels
    - CK = GP ^ RR ^ GG ^ BB ^ 0x55 (the old RR^GG^BB^0x5A ignored the group and
    only matched the high nibble for groups 0-15)
    - 61 captured payloads are now a unit test
    Receiver mode: a Dashboard switch (config "role": "receiver") turns the
    controller into a listener. The CC1101 outputs demodulated OOK on GDO0 (IO33,
    no rewiring), an edge interrupt times it, and a host-tested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
    [config.cpp, config.h, engine.cpp, engine.h, panel.cpp, radio.cpp, radio.h]
2026-10-07 Add a Seeed XIAO ESP32-S3 build target
    New PlatformIO env xiao-esp32s3 (-DNET2RF_BOARD_XIAO_S3), wired like
    CrispyPyro/Wireless_DMX_Receiver: CC1101 CS D3, GDO0 D4 (TX and RX data),
    SCK D8, MISO D9, MOSI D10. Wi-Fi only. OLED on D6/D7, the BOOT button as
    USER, the onboard LED (active low) as status LED.
    - src/pins.h: per-board pin maps, board id/name, Ethernet presence
    - net: Ethernet is only started on boards that have it; status reports
    ethernet.present and the UI hides the Ethernet setting without it
    - factory image: bootloader at 0x0 on the S3 (0x1000 only on the ESP32)
    - releases: the S3 files are net2rf-led-xiao-esp32s3-<v>.bin; the updater
    and the UI only offer/accept this board'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
2026-10-07 Receiver mode: RX tuning profiles, Ra-02 receive, raw pulse capture
    Radio tuning: receiver mode gets its own register set instead of the transmit
    one, with three profiles (rx_profile in /api/config, a selector on the card):
    - normal: CC1101 162 kHz, TI DN022 OOK AGC, RX front end for >100 kHz filters;
    SX1278 166.7 kHz with AGC
    - near: gain capped (CC1101 AGCCTRL 0xD3/0x09/0xF1 as in CrispyPyro's
    near-field mode; SX1278 LNA fixed at -24 dB) for a transmitter close by,
    which otherwise overloads the OOK slicer
    - wide: 325 / 250 kHz for transmitters well off frequency
    Leaving receiver mode restores the transmit / listen-before-transmit values.
    Ra-02 (SX1278): continuous-mode RX with the b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
    [config.cpp, config.h, engine.cpp, engine.h, panel.cpp, radio.cpp, radio.h]
2026-10-07 Rename "bracelet" to "device" in the web UI, source and API
    The controller drives bracelets, sticks, pucks and wands alike.
    - Web UI: "Devices & Radio", "Device protocols", "Device reacted" and the
    wording throughout.
    - Source: lib/bracelet_protocol is now lib/net2rf_protocol (rf_protocol.h,
    rf_rx.h), namespace rfproto; comments and log messages say "device".
    - API: the settings key "bracelets" is now "devices".
    - Docs updated for the renamed page, settings key and library paths. Prose
    about actual bracelet products, and the name of the third-party Flipper app
    (bracelet_led.fap), keep the word.
    [config.cpp, config.h, engine.cpp, engine.h, panel.cpp, radio.cpp, test_main.cpp]
2026-10-07 Settings in two parts: network and everything else
    The controller already kept two records; they are now handled separately
    everywhere, so either can be cleared, exported or imported without the other.
    - Parts: "network" (hostname, Ethernet / Wi-Fi, IP, setup hotspot, admin
    password) and "settings" (zones, devices, radio, input, display, updates).
    - Export: GET /api/export?part=settings|network, one file per part (no `part`
    = both). Import replaces only the parts the file holds; the
    include_network flag is gone.
    - Reset: POST /api/reset {"what": "settings" | "network" | "all"}. System
    page: Reset settings, Reset network, Factory reset.
    - No upgrade path: a record with another layout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
    [config.cpp, config.h, test_main.cpp, web.cpp]
2026-10-07 USER button: show the pending reset on the status LED
    While USER is held the LED is steady for a plain press, blinks slowly from
    5 s (releasing resets the network part) and rapidly from 15 s (factory
    reset), so controllers without an OLED get the same feedback.
    [panel.cpp]
2026-10-08 Receiver mode: hold the capture buffers only while it is on
    They were reserved permanently (about 14 KB), which left too little memory for
    the secure firmware download: installs from GitHub stalled on a controller that
    only transmits. They are now taken when receiver mode starts and given back
    when it stops or a firmware update begins.
    [engine.cpp, engine.h]
2026-10-08 Network: OLED screen for a dropped connection, Wi-Fi power saving off
    When a working connection is lost the OLED wakes and shows which interface,
    the reason and how often, for 30 seconds; the record stays in /api/status
    (network.drops, network.last_drop). Wi-Fi modem sleep is off: it delayed
    incoming DDP by up to a beacon interval (ping 100 ms -> 15 ms).
2026-10-08 Updates from GitHub: resume a stalled download, light progress reply, low-memory warning
    - A download that stalls is picked up from where it stopped (HTTP Range), with
    the stall's details in the error text if it still fails.
    - GET /api/update/status: the download job only; the web UI polls it during an
    install in place of the full status, which ran out of memory.
    - GET /api/crash: the last crash from the dump kept in flash.
    - Free memory bar: amber / red by the amount free, with a note that an update
    from GitHub may stall.
    [updater.cpp, web.cpp]
2026-10-08 Board records on the data partition: boot log, heard transmitters, saved captures
    The 128 KB "spiffs" partition is now LittleFS holding small JSON files (lib/net2rf_store, src/store.cpp):
    - boots.json: the last 32 restarts (reason, firmware, how long the run before lasted, crash address).
    After 5 abnormal restarts in a row nothing is written until a boot has stayed up a minute.
    - seen.json: transmitters receiver mode decodes. Kept in memory always; written to flash only when
    "Record this list to flash" is switched on (a new transmitter within a minute, counts every 15).
    - cap0-5.json: receiver captures kept with the new Keep button.
    Every file carries a running write count, shown on the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
    [engine.cpp, engine.h, main.cpp, store.cpp, store.h, test_main.cpp, web.cpp]
2026-10-10 Carrier R2.0 pin map, Ra-02 default, updates checked by the browser
    Pins (WT32-ETH01), to match carrier board R2.0:
    - Radio SPI: SCK IO4, MOSI IO14, chip-select IO15 (was IO14 / IO15 / IO4)
    - I2C: SDA IO17, SCL IO5 (was IO5 / IO17)
    - A new or reset WT32-ETH01 controller starts on the SX1278 (Ra-02); the
    XIAO ESP32-S3 build still starts on the CC1101.
    Existing hand-wired WT32-ETH01 units need those five wires moved.
    Updates:
    - The controller no longer contacts GitHub. The browser checks for a new
    release and reports it (POST /api/update/latest), and installs by
    fetching the firmware from the project's Pages site and uploading it.
    Uploading a file by hand is unchanged.
    - Removes on-de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
    [config.cpp, config.h, engine.h, main.cpp, pins.h, store.cpp, test_main.cpp]
2026-10-10 Docs: Wally's Lights bracelets tested on protocol 1
    First real protocol 1 devices driven by the controller (Zone 1 bracelets, Ra-02):
    they follow group 0 and group 1, dim through the full range on each channel,
    take about 10 s to start after power-on, and flicker at low levels.
2026-10-14 Coverage group: several controllers share one show in time slots
    One controller is the master (xLights sends to it); the others are remotes.
    Discovery rides on the heartbeat (new mac / sync / master fields). Remotes
    keep an NTP-style clock offset to the master over unicast UDP 4050; for each
    change the master plans back-to-back slots (copies x frame + guard, rotating
    order) and sends every synced remote its slot. Final states get one extra
    copy and the master adds a settle repeat a second after a lane stops changing.
    - lib/net2rf_group: wire format, clock filter, roster, planner, master
    tracker, remote queue (host-tested)
    - settings: sync.enabled / master / copies; heartbeat fields
    - engi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
2026-10-19 Carrier R2.0 SPI pins as routed, with the J3 9-10 bridge
    The R2.0 carrier board is routed with SCK on IO15, MISO on IO14, MOSI on IO35
    and radio CS on IO4. IO35 is input-only and cannot drive MOSI, so R2.0 boards
    need J3 pins 9 and 10 bridged (IO12 to IO35), and the firmware now drives MOSI
    from IO12. IO12 is a strapping pin. Its internal pull-down keeps it low at
    reset, and nothing on the MOSI line pulls up.
    pins.h: SCK 15, MOSI 12, MISO 14, CS 4. ASSEMBLY.md and the wiring diagram
    match, and a hardware note in the carrier section explains the bridge and the
    power-on start problem (press EN).
    Tested on an R2.0 board at 192.168.250.230 with the bridge fitted. The radio
    reports ready and th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
2026-10-20 Docs: airtime math for one controller and a coverage group
    One bracelet frame is about 46.6 ms on air, so one channel carries at most about
    21 frames a second. This adds a table of changes per second by repeat count for
    a single controller and by group size, the per-change formula for a coverage
    group, what filling the airwave means, and sequencing advice. It recommends
    budgeting 30-50% airtime.
2026-10-31 Fade and flicker modes, start at power-up, amp power switch, Tools sections
    - Test mode gains Fade (a palette held and faded round and round, 1-8
    colours, fade/hold times; Halloween, Christmas and red-white-blue
    presets) and Flicker (a candle in the chosen colour, about 3 changes/s).
    - "Start this mode at power-up": the running test mode and its colours
    start again after every boot (own NVS record, AppConfig unchanged).
    - Amplifier power switch on IO2 (XIAO: D1): /api/amp and device.amp in the
    status, fitted / active_low / on kept across restarts. Not fitted by
    default; while fitted, the status LED on the shared pin is not driven.
    - Tools page: everyday tools always shown, plus an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
2026-10-31 Check in the carrier board case (R27, amp and slim variants)
    hardware/case: OpenSCAD source, STLs for the amp case and the slim case,
    SSD1315 OLED lids, the antenna plug, mounting brackets, two fit test
    pieces, renders and a README. The rest of hardware/ stays local.
2026-10-31 Docs: catch up the IO2 note, stats modes, settings, Home Assistant, devices
    - ASSEMBLY: IO2 may also carry the amplifier power switch (with a pull-down).
    - API: stats test_mode values include fade and flicker.
    - USAGE: the power-up test mode and the amp switch are kept apart from the
    exported settings; only a factory reset clears them.
    - HOME_ASSISTANT: fade and amp rest commands, a sunset holiday fade example.
    - DEVICES: fade/flicker and the amp switch in the tested-features table.
2026-10-31 Case R28: a stable set, every part regenerated
    The slim lid's side snap ridges at the antenna end ran 3.5 mm past the end
    of the side lip and into the far wall. The side ridges now stop where the
    lips do (y -0.5 to 8 on the slim lid). The base's grooves keep their full
    length, so only the slim lid's shape changed; every other part differs only
    in the engraved revision. On an R27 slim lid, trim the ridge ends flush.
2026-10-31 Add carrier board and case photos
    Thirteen photos of the R2.0 carrier board, the amp case and both slim case
    builds, resized to 1400 px with all metadata (including GPS) stripped. The
    README shows three under the dashboard and a full gallery under Hardware;
    the case README links a few.
2026-10-31 Docs: the carrier board R2.0 is tested
    Drop "coming soon" from the README, ASSEMBLY, DEVICES and TODO. The carrier
    board and its Ra-02 radio move to tested; part B describes the board and keeps
    the R2.0 notes (J3 bridge, EN at power-on).
2026-10-31 Docs: Wally's Lights wristbands, pucks, wand and Santa hat tested
    All four are protocol 1 and follow the controller with our sync timing.
    DEVICES, PROTOCOL, README and TODO updated; groups other than all, idle
    behaviour and xLights stay open for these devices.
2026-10-31 README: link the prototype video instead of embedding its thumbnail
2026-10-31 TODO: close the carrier board and protocol 1 sync timing items
2026-10-31 Docs: SSD1315, USER button, factory reset, OLED wake and protocol 1 tested
2026-10-31 DEVICES: fade has run on Wally's Lights pucks
2026-10-31 Docs: FPP as the show player and protocol 1 tested across the board
2026-11-02 Firmware for v0.2.0: new defaults, saved presets, amp idle power-down
    Protocol 1 and listen before transmit are on for new controllers; saved
    settings keep their own. A mode started at power-up gives way to live
    show input. Adds saved fade presets, amp idle power-down, a visible
    Wi-Fi scan list, and board and connection in the status broadcast.
    Export and import now cover the power-up mode, amp and presets. Removes
    1.3 inch OLED support and old API fields.
2026-11-02 Case: name the OLED lids by size, not chip
    OLED is now "standard" or "small", and the STLs are renamed to match.
    Same shapes, still R28.
2026-11-02 Docs: product-style README, reorganised guides, changelog-driven releases
    The README becomes a product page, with guides, build notes and technical
    reference under docs/. Adds pages for several controllers, the amplifier
    and flashing, new wiring and amp switch drawings, CONTRIBUTING and
    CHANGELOG. The release workflow now publishes the changelog section as
    the release notes.
2026-11-04 Heartbeat: radio budget (repeats, synced remotes, copies) for senders
    Every status broadcast now carries "rep" (repeats per change); a coverage
    group master's also carries "rem" (remotes synced now, each taking a slot)
    and "cp" (copies per controller). A beat goes out at once when the repeats
    or the synced remotes change. Older readers ignore the fields; the format
    stays at v1. /api/stats gives "repeats" too, so it can be read behind an
    admin password.
    The FPP plugin (fpp-net2rf) uses them to set its change rate.
    Tested on two WT32-ETH01 controllers; the largest beat still fits in
    HEARTBEAT_MAX. CHANGELOG has a 0.2.1 section, still unreleased.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
2026-11-04 Web UI: System's Firmware card was blank on a controller with an OLED
    sysInfo() read device.display_info.type, which v0.2.0 removed from
    /api/status; the TypeError aborted render(), and poll() reported it as
    "offline". The Display row now reads "OLED at <address>".
2026-11-06 RF output: one switch for the air; the amp follows it; restart radio
    - Remove the Radio power switch and /api/radio; add POST /api/radio/restart and GET /api/output
    - Amp: follow_output (default on) powers it with RF output; Use amplifier off holds every transmission
    - Dashboard and Tools show the amp's power state and why it's off
    - Amplifier docs: EN-to-input resistance check, 2N7000
2026-11-06 Docs: amplifier switch checks, troubleshooting and audio interference
